alexist2623/QSTL_Amplifier/README.md

# QSTL_Amplifier
QSTL Baseband Amplifier

- [Current Altium Rev D review project](hardware/THS3491_RGT_G20/altium_revD/QSTL_THS3491_RGT_G20_RevD.PrjPcb)
- [Rev D changes, verification and Altium compatibility status](hardware/THS3491_RGT_G20/altium_revD/README.md)
- [Design requirements](DESIGN_REQUIREMENTS.md)

Rev D implements the latest capacitor and PD/NC placement corrections. It is a
review snapshot. Altium 25.8.1 open/save/reopen is verified after repairing track
and pad layer encoding; native ERC, repour and DRC remain pending.
