alexist2623/QSTL_Amplifier/hardware/THS3491_RGT_G20/altium_revD/review/bottom_mask_cleanup_baseline/README.md

Historical baseline before bottom-pad projection cleanup and mounting-via exposure, 2026-10-30.
