alexist2623/QSTL_Amplifier/hardware/THS3491_RGT_G20/altium_revD/review/mount_mask_baseline/README.md

Historical baseline before mounting-hole solder-mask expansion on 2026-10-30.
