alexist2623/QSTL_Amplifier/hardware/THS3491_RGT_G20/altium_revD/review/l3_cleanup_baseline/README.md

Historical baseline before the 2026-10-30 L3 plane cleanup. Current CAD files are in the parent altium_revD directory.
