alexist2623/QSTL_Amplifier/hardware/THS3491_RGT_G20/altium_revD/review/rf_resistor_windows_baseline/README.md

Historical verified baseline before the RF resistor-window/U1 correction on 2026-10-30.
