alexist2623/QSTL_Amplifier/hardware/THS3491_RGT_G20/altium_revD/review/bottom_ground_mask_and_vias.png

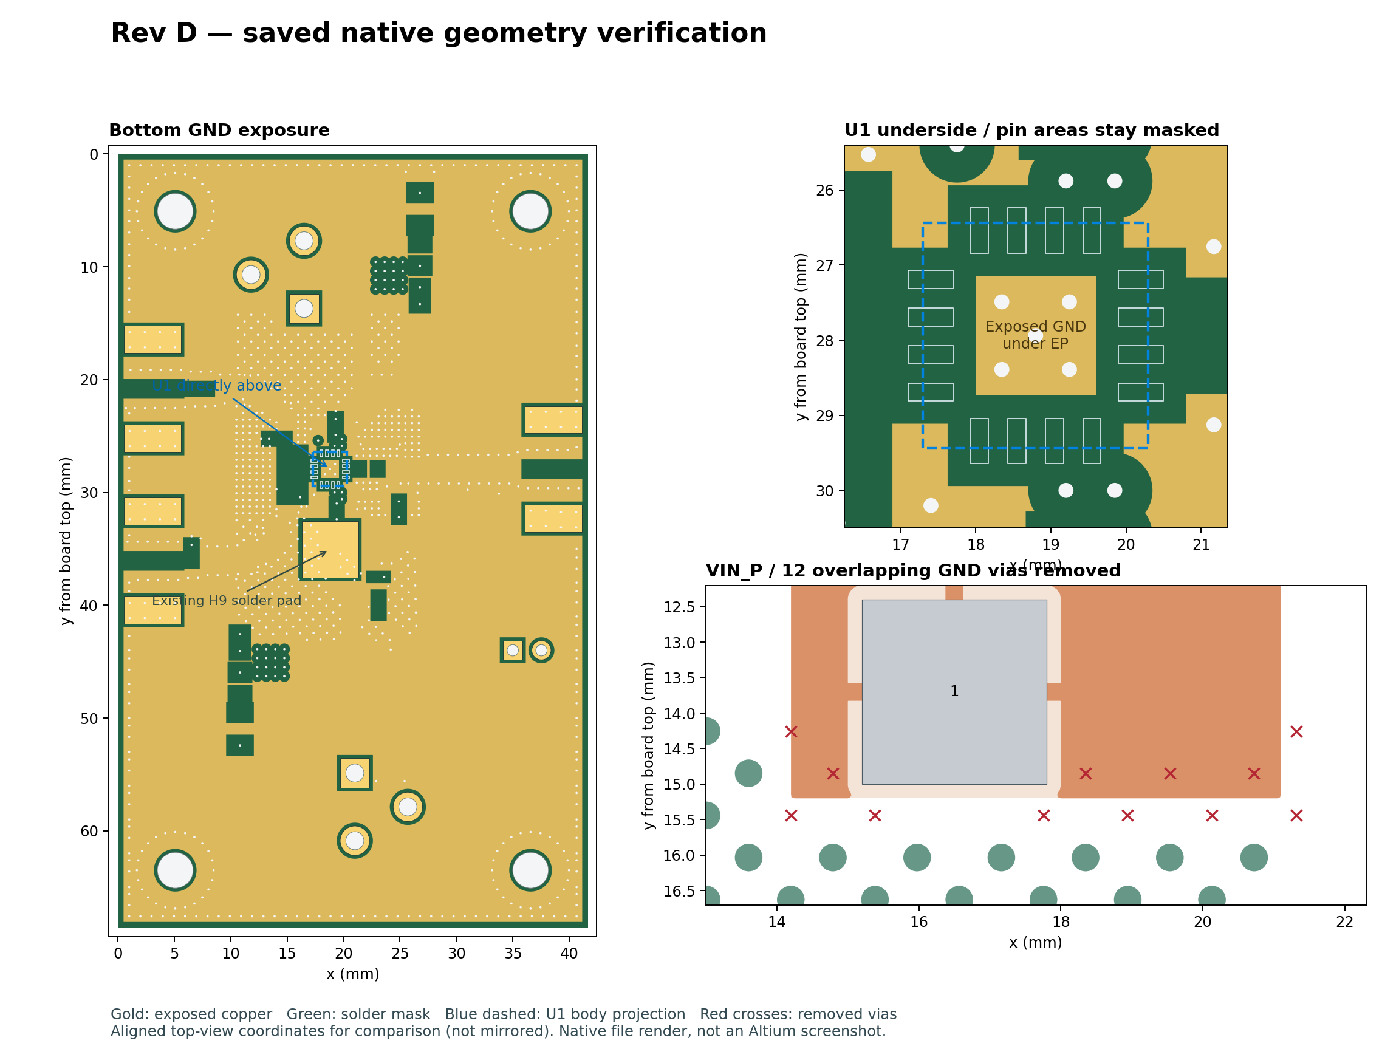
hardware/THS3491_RGT_G20/altium_revD/review/bottom_ground_mask_and_vias.png
