alexist2623/QSTL_Amplifier/hardware/THS3491_RGT_G20/altium_revD/review/bottom_mask_cleanup_before_after.png

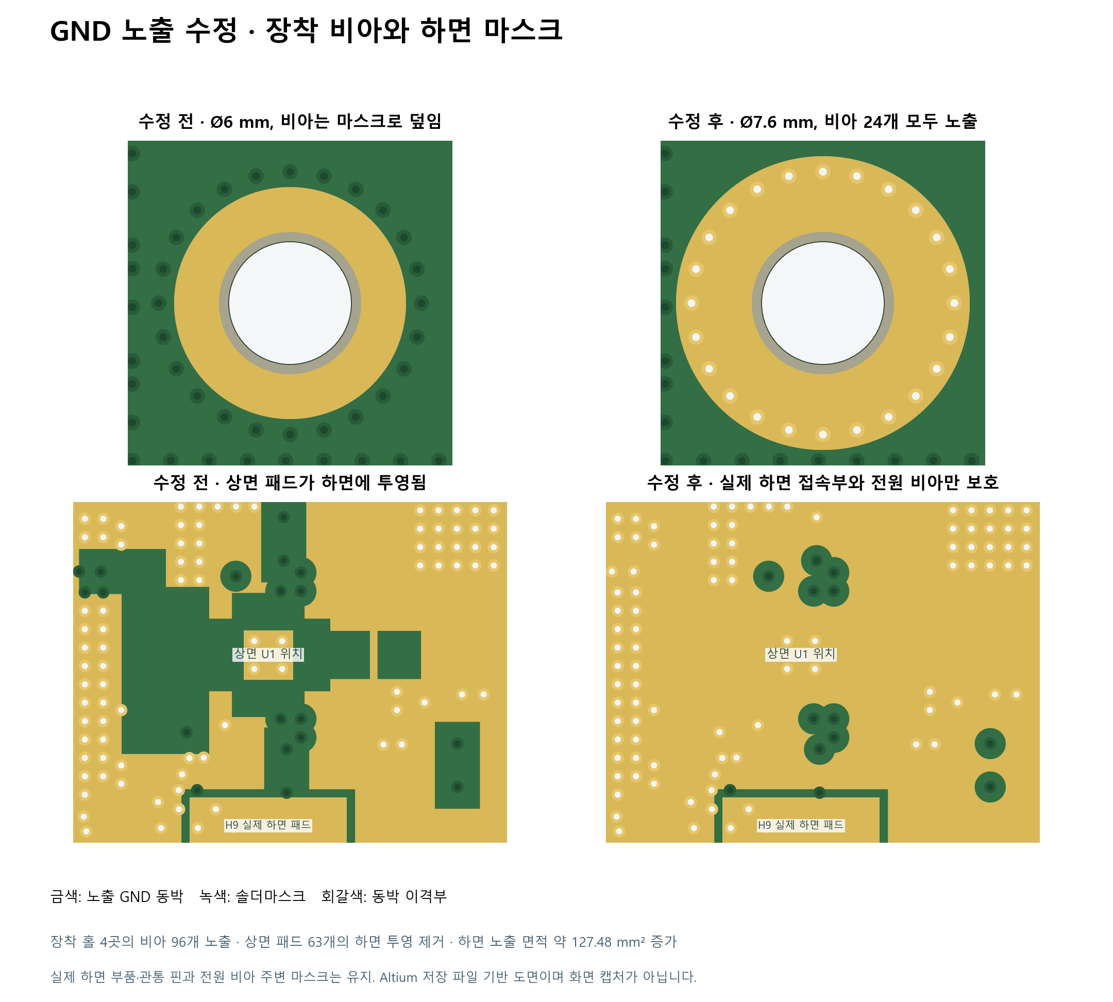
hardware/THS3491_RGT_G20/altium_revD/review/bottom_mask_cleanup_before_after.png
