alexist2623/QSTL_Amplifier/hardware/THS3491_RGT_G20/altium_revD/review/dc_plane_pinout.png

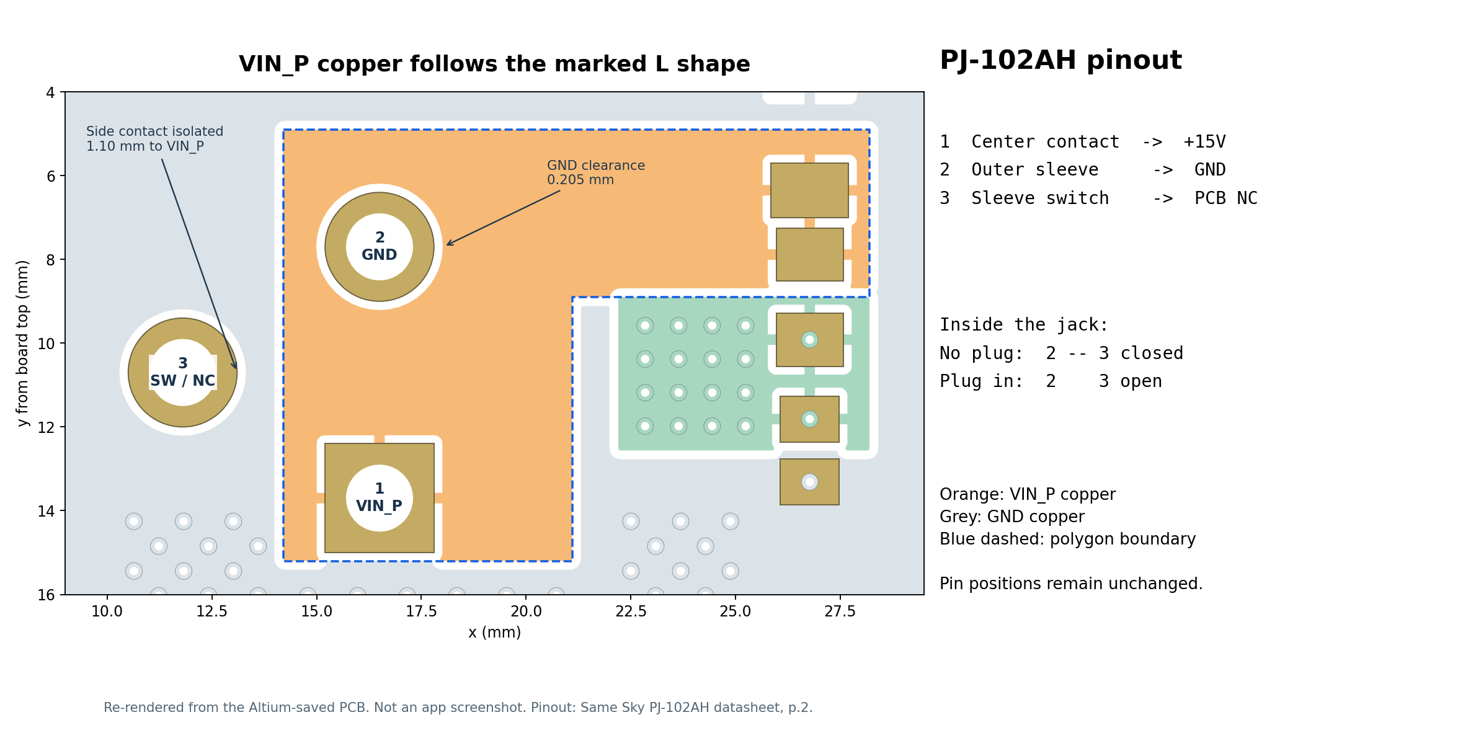
hardware/THS3491_RGT_G20/altium_revD/review/dc_plane_pinout.png
