alexist2623/QSTL_Amplifier/hardware/THS3491_RGT_G20/altium_revD/review/dc_planes_both.png

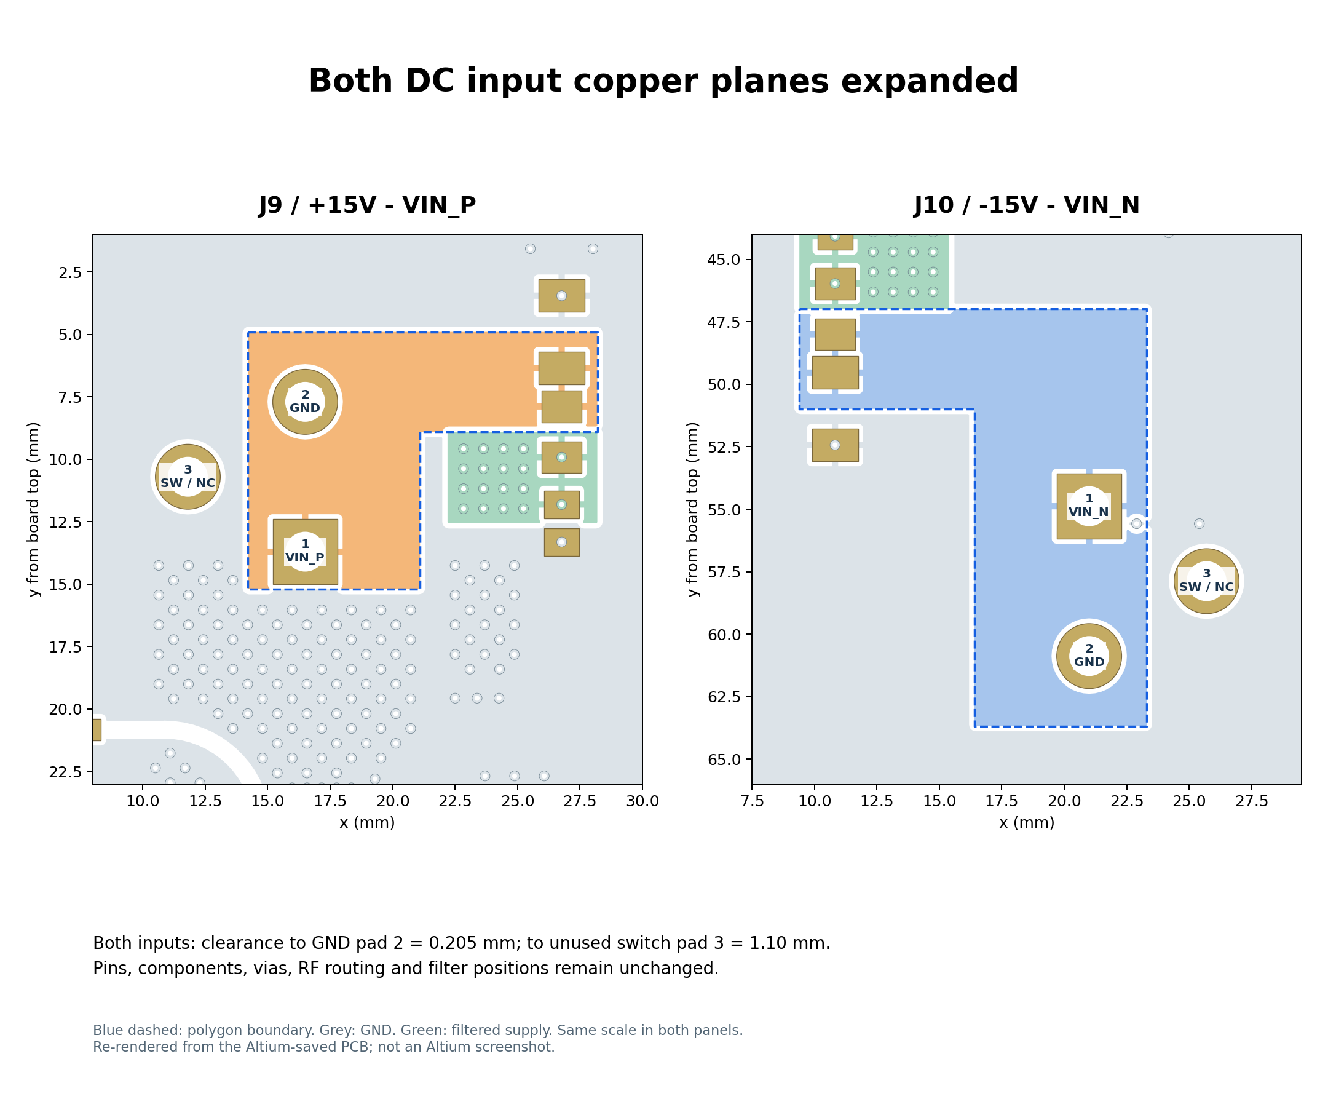
hardware/THS3491_RGT_G20/altium_revD/review/dc_planes_both.png
