alexist2623/QSTL_Amplifier/hardware/THS3491_RGT_G20/altium_revD/review/entry_plane_via_arrays.png

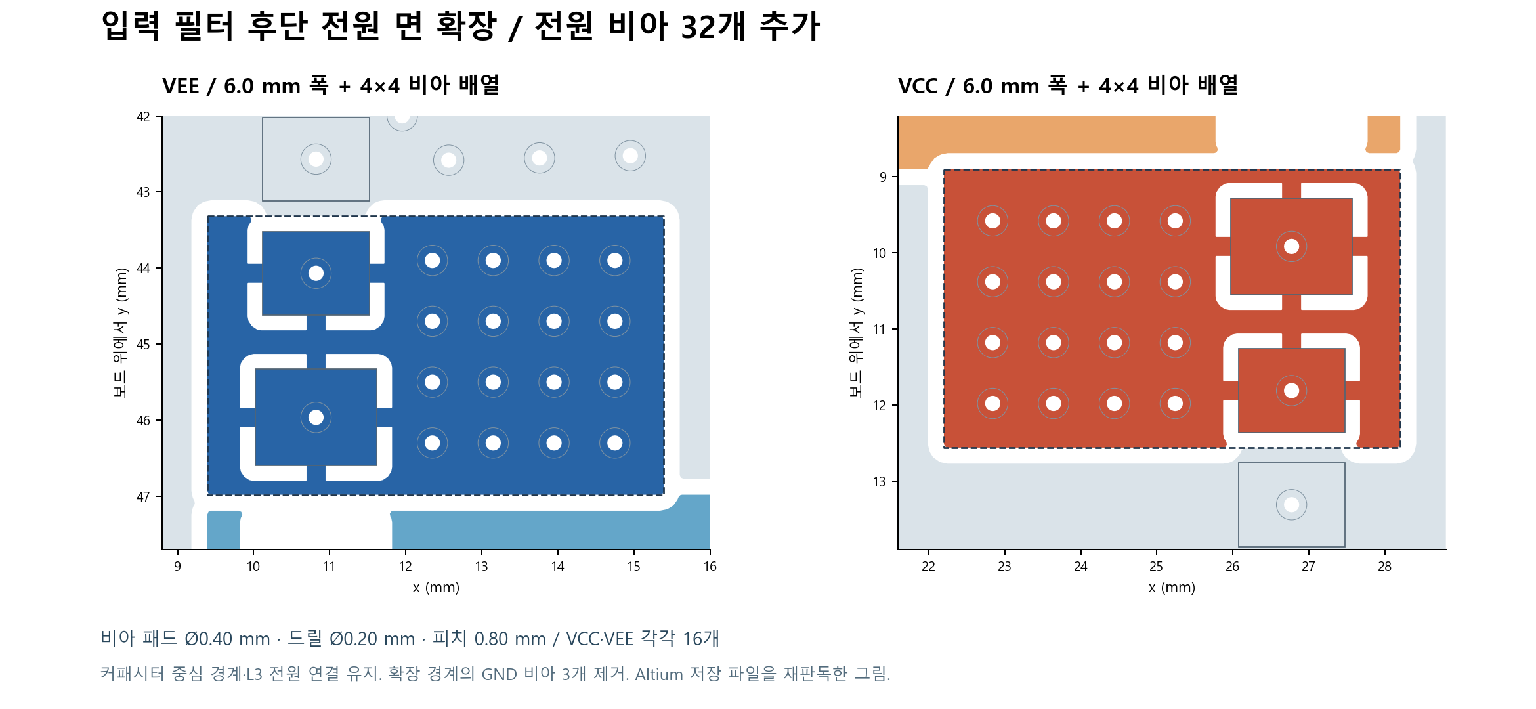
hardware/THS3491_RGT_G20/altium_revD/review/entry_plane_via_arrays.png
