alexist2623/QSTL_Amplifier/hardware/THS3491_RGT_G20/altium_revD/review/L2_resistor_windows_before_after.png

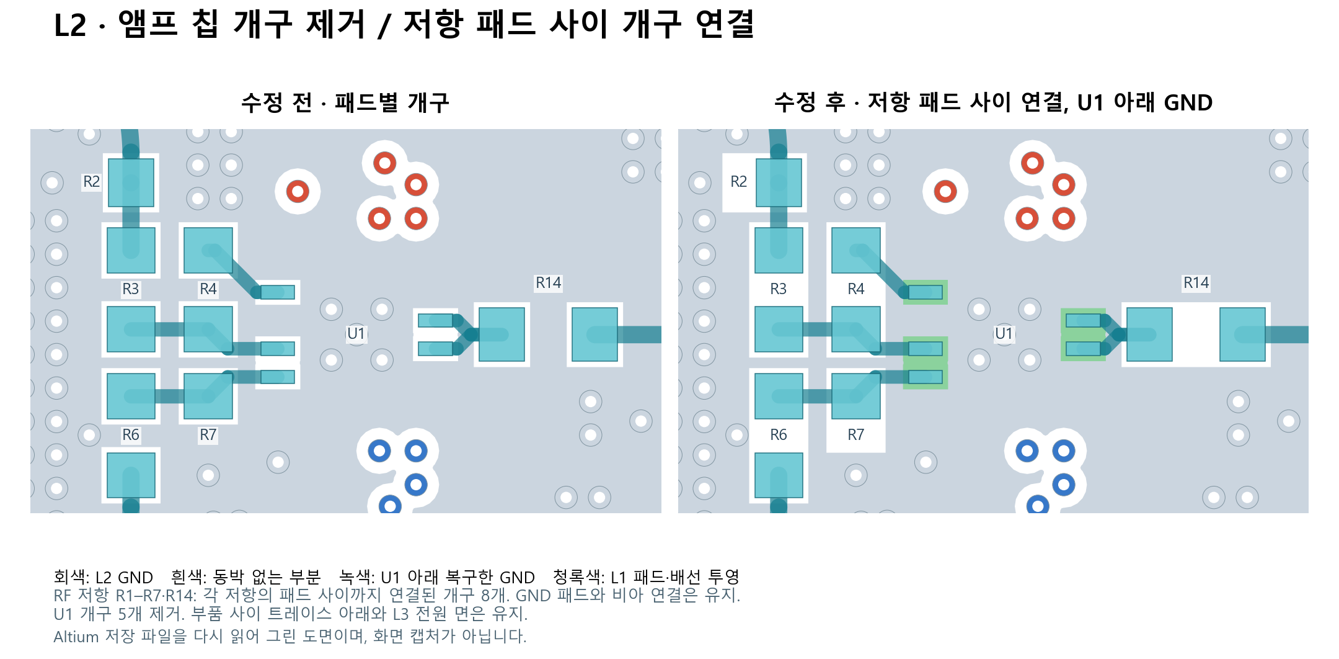
hardware/THS3491_RGT_G20/altium_revD/review/L2_resistor_windows_before_after.png
