alexist2623/QSTL_Amplifier/hardware/THS3491_RGT_G20/altium_revD/review/layers/L1-L4_overview.png

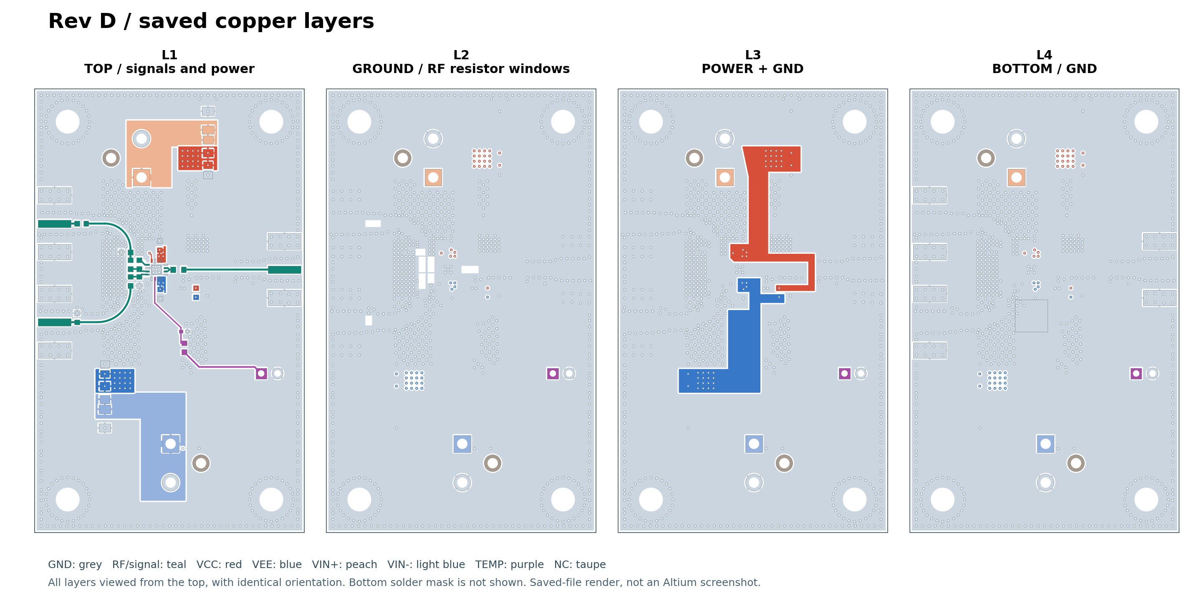
hardware/THS3491_RGT_G20/altium_revD/review/layers/L1-L4_overview.png
