alexist2623/QSTL_Amplifier/hardware/THS3491_RGT_G20/altium_revD/review/layers/L4.png

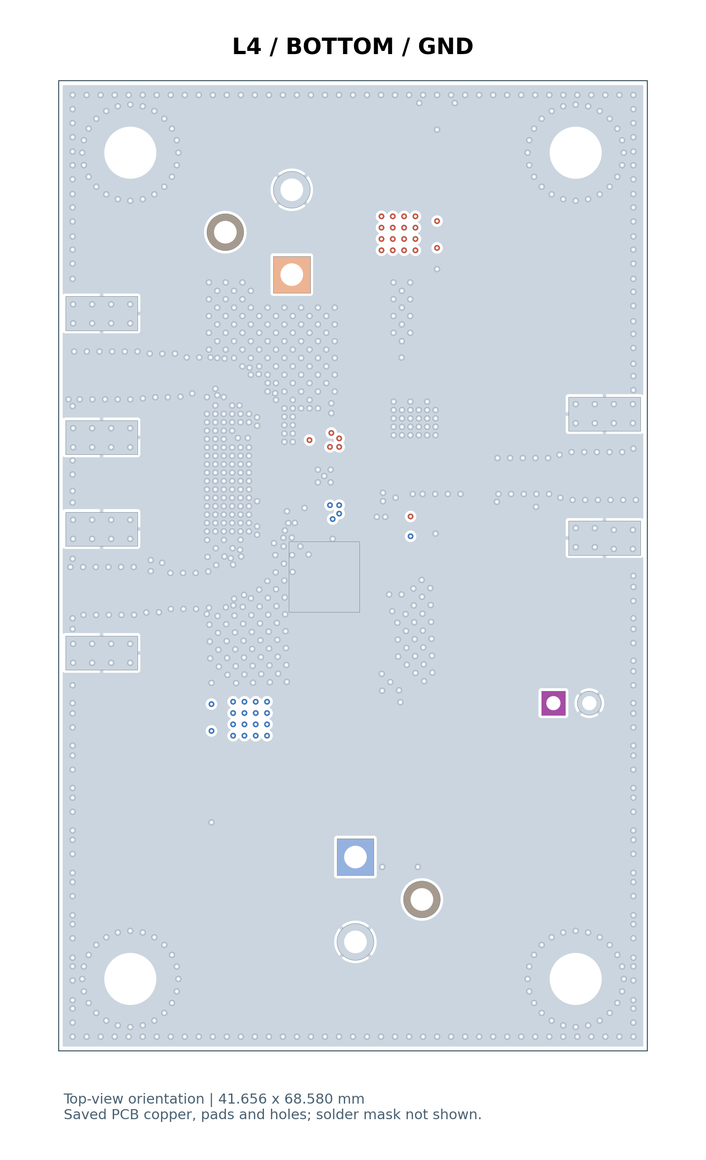
hardware/THS3491_RGT_G20/altium_revD/review/layers/L4.png
