alexist2623/QSTL_Amplifier/hardware/THS3491_RGT_G20/altium_revD/review/mechanical_compare_THS4021EVM.png

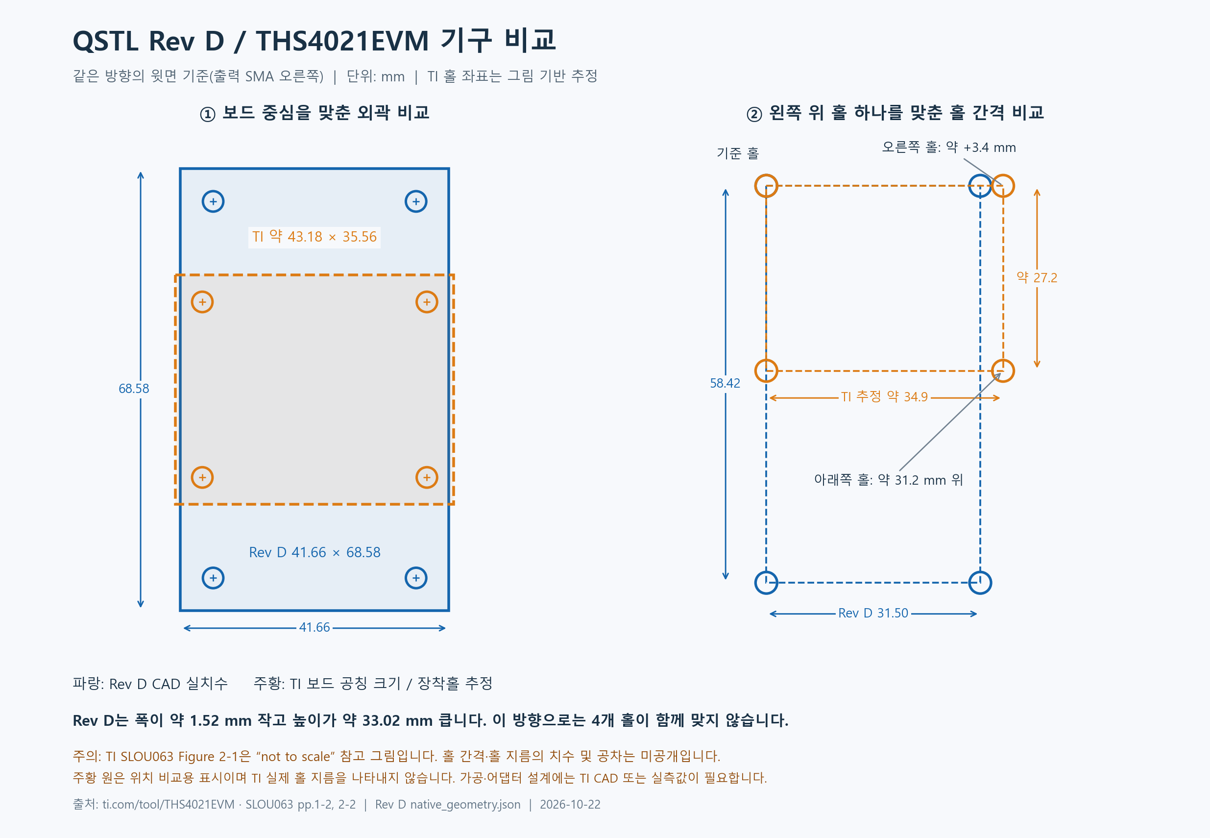
hardware/THS3491_RGT_G20/altium_revD/review/mechanical_compare_THS4021EVM.png
