alexist2623/QSTL_Amplifier/hardware/THS3491_RGT_G20/altium_revD/review/mechanical_hole_via_rings.png

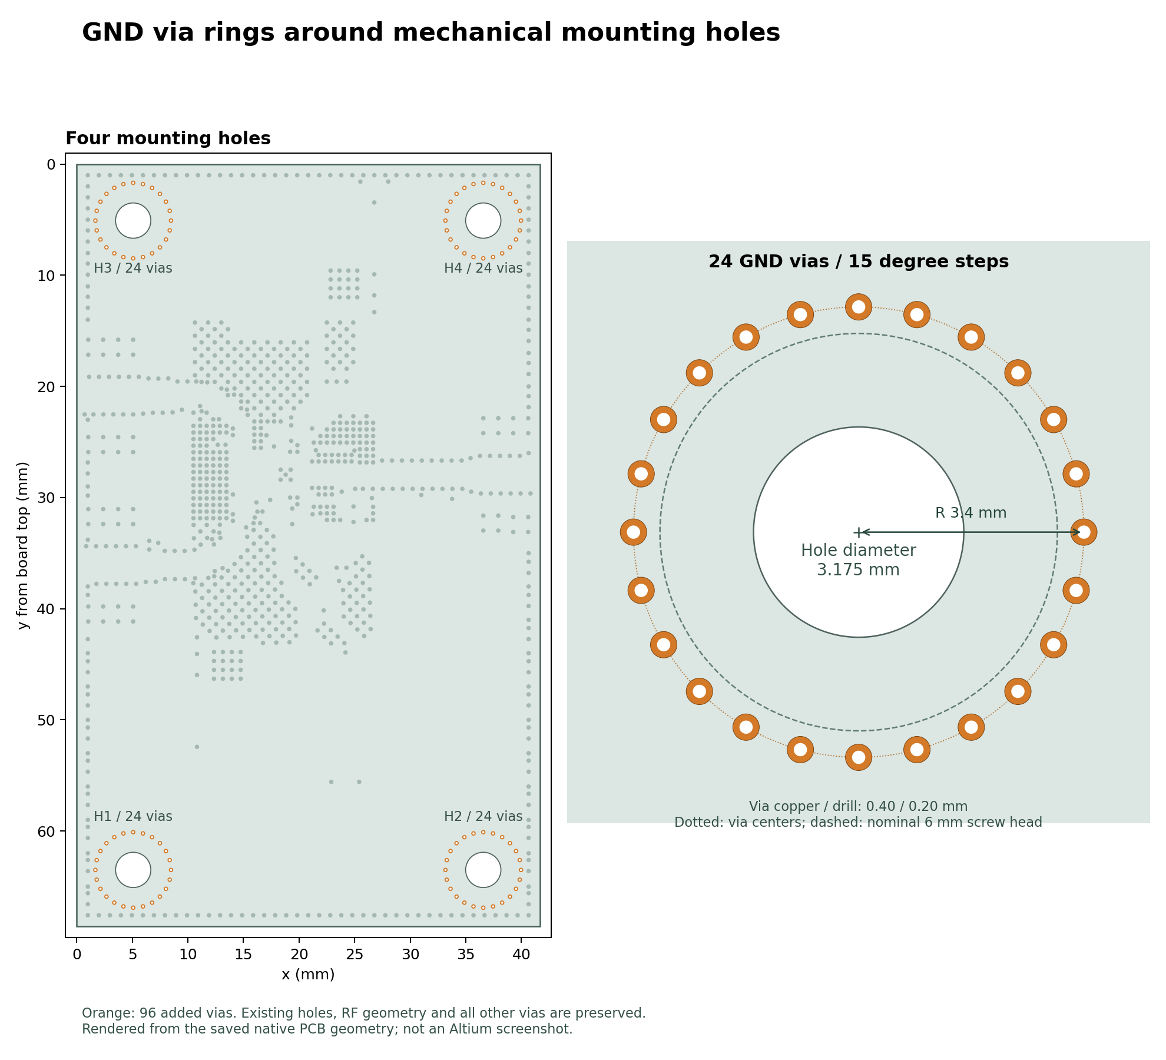
hardware/THS3491_RGT_G20/altium_revD/review/mechanical_hole_via_rings.png
