alexist2623/QSTL_Amplifier/hardware/THS3491_RGT_G20/altium_revD/review/mounting_hole_copper_exposure.png

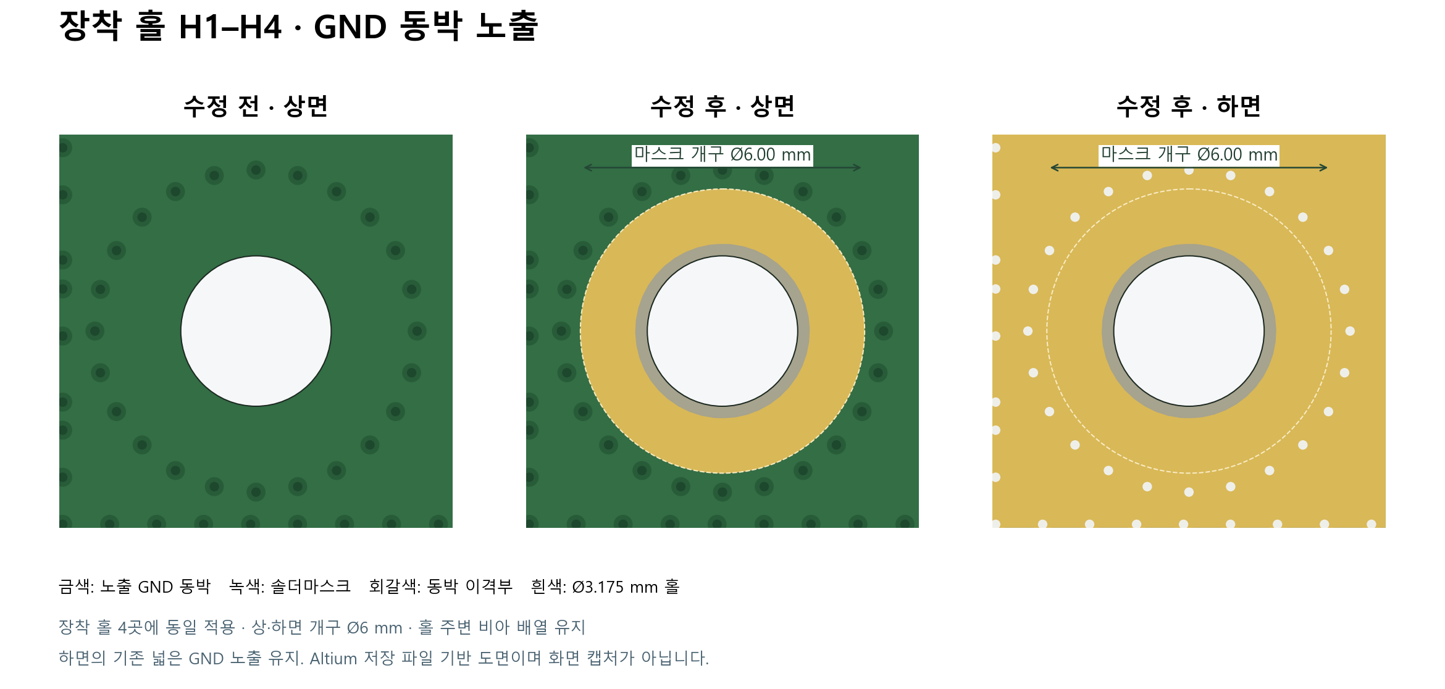
hardware/THS3491_RGT_G20/altium_revD/review/mounting_hole_copper_exposure.png
