alexist2623/QSTL_Amplifier/hardware/THS3491_RGT_G20/planning/power_plan_L1.png

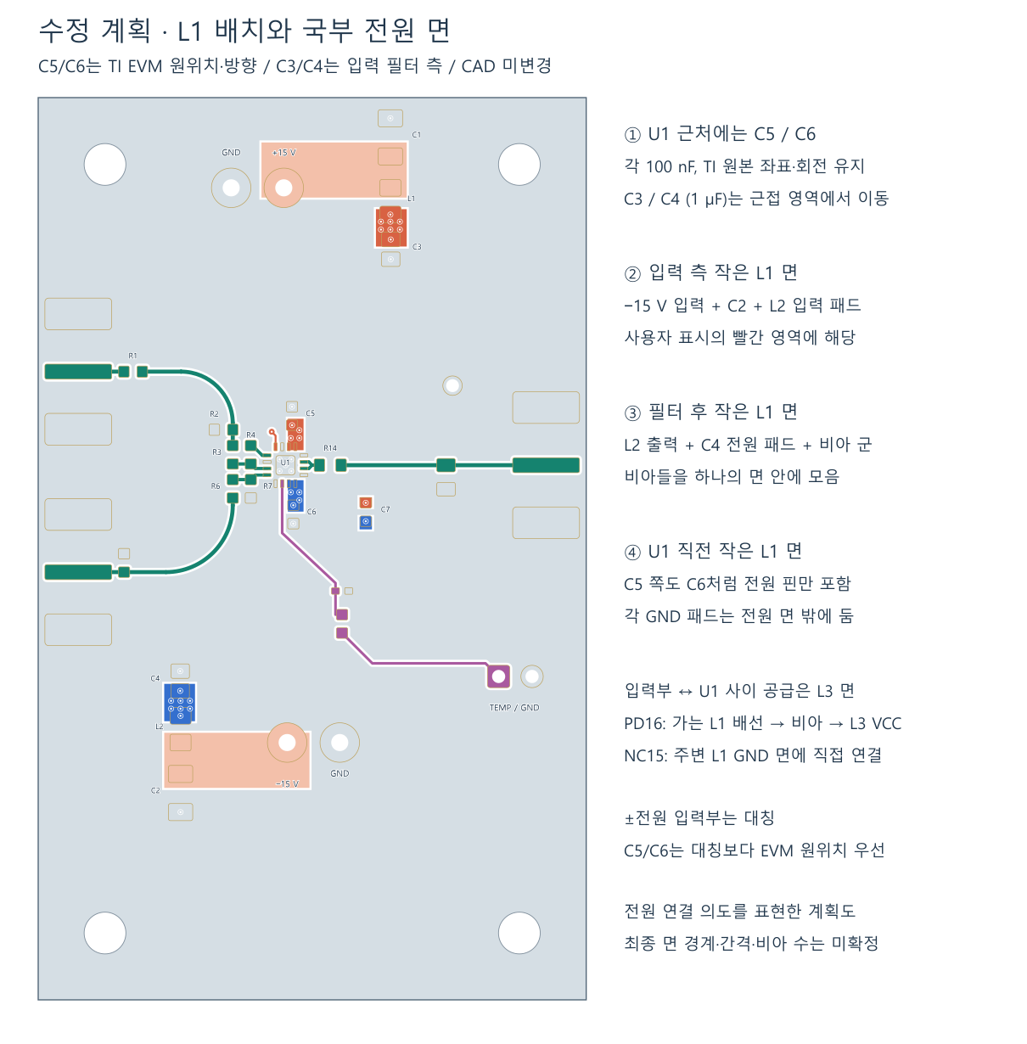
hardware/THS3491_RGT_G20/planning/power_plan_L1.png
