alexist2623/QSTL_Amplifier/hardware/THS3491_RGT_G20/planning/power_plan_PD_NC.png

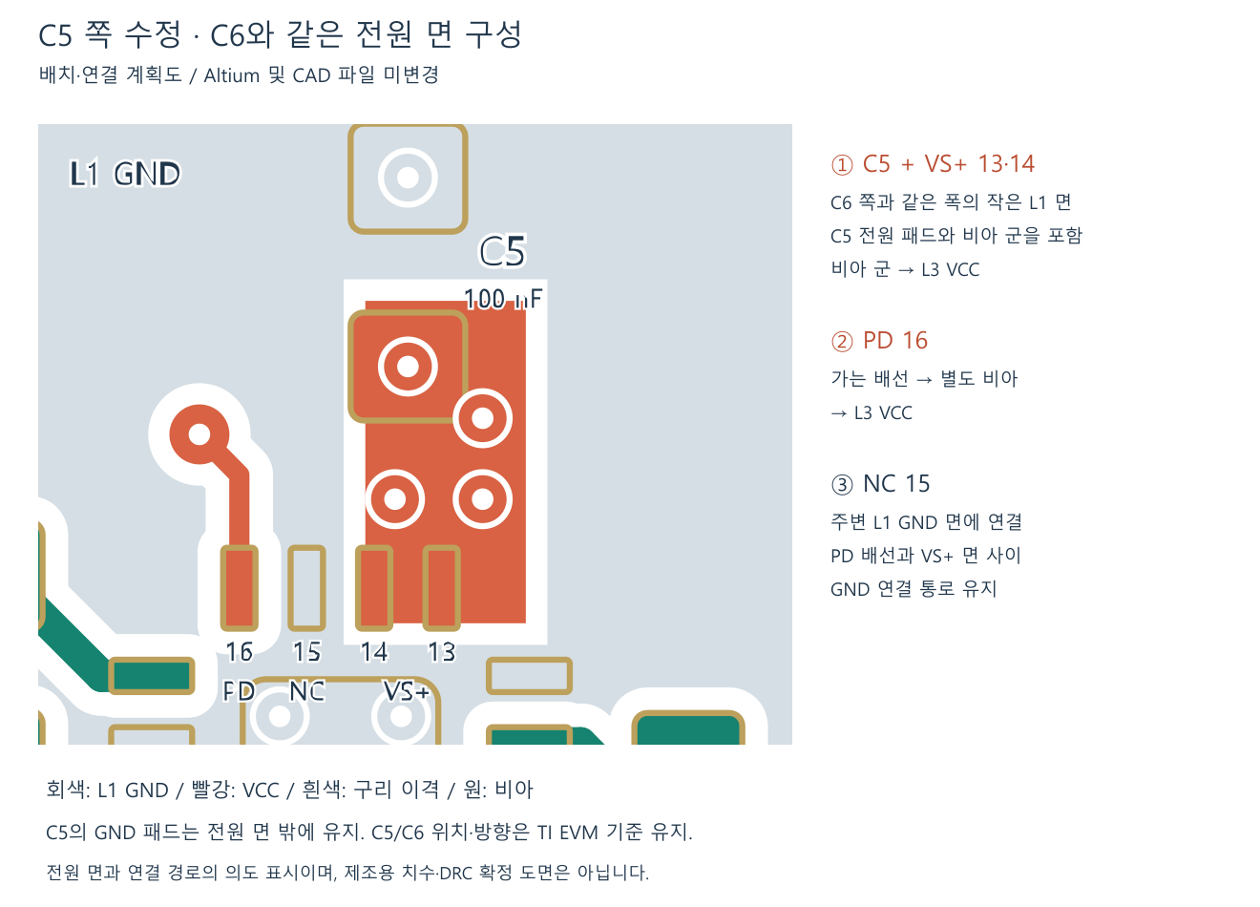
hardware/THS3491_RGT_G20/planning/power_plan_PD_NC.png
