alexist2623/QSTL_Amplifier/hardware/THS3491_RGT_G20/altium_revD/models3d/Ferrite_0805_H0p85.step

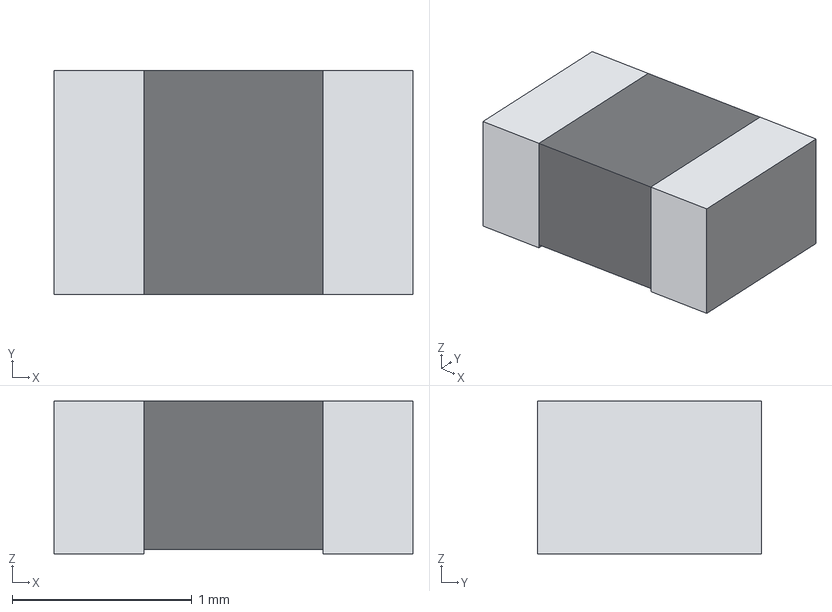
[picture p34: CAD file, 2026-10-29]
hardware/THS3491_RGT_G20/altium_revD/models3d/Ferrite_0805_H0p85.step
2.00 x 1.25 x 0.85 mm
