alexist2623/QSTL_Amplifier/hardware/THS3491_RGT_G20/altium_revD/models3d/sources/SMA_142-0701-851.stp

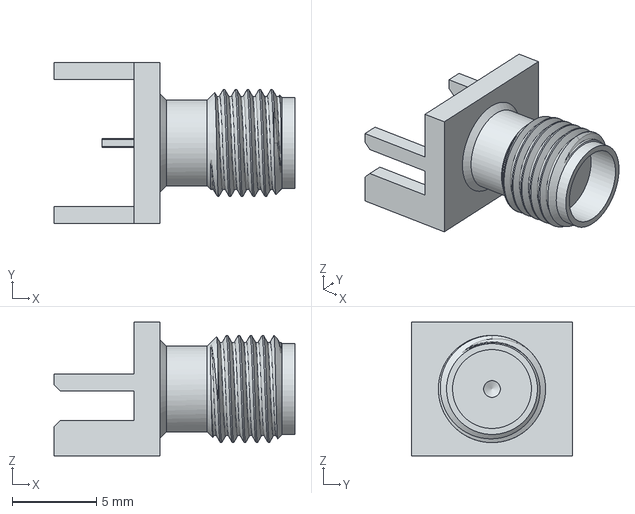
[picture p35: CAD file, 2026-10-29]
hardware/THS3491_RGT_G20/altium_revD/models3d/sources/SMA_142-0701-851.stp
14.3 x 9.53 x 7.92 mm
