alexist2623/QSTL_Amplifier/hardware/THS3491_RGT_G20/altium_revD/models3d/C_1206_H0p85.step

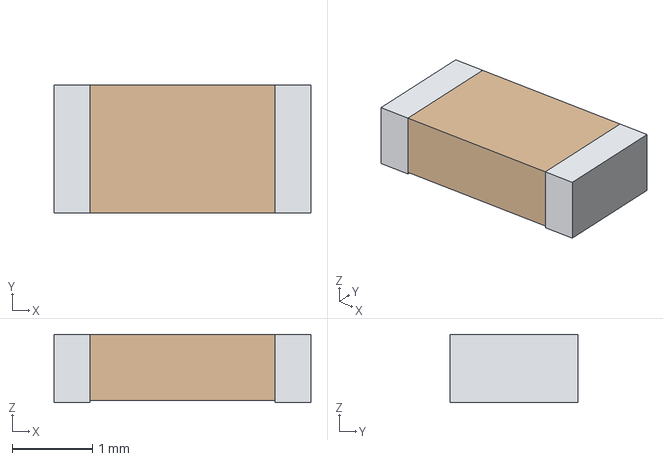
[picture p36: CAD file, 2026-10-29]
hardware/THS3491_RGT_G20/altium_revD/models3d/C_1206_H0p85.step
3.20 x 1.60 x 0.85 mm
