alexist2623/QSTL_Amplifier/hardware/THS3491_RGT_G20/altium_revD/models3d/C_0805.step

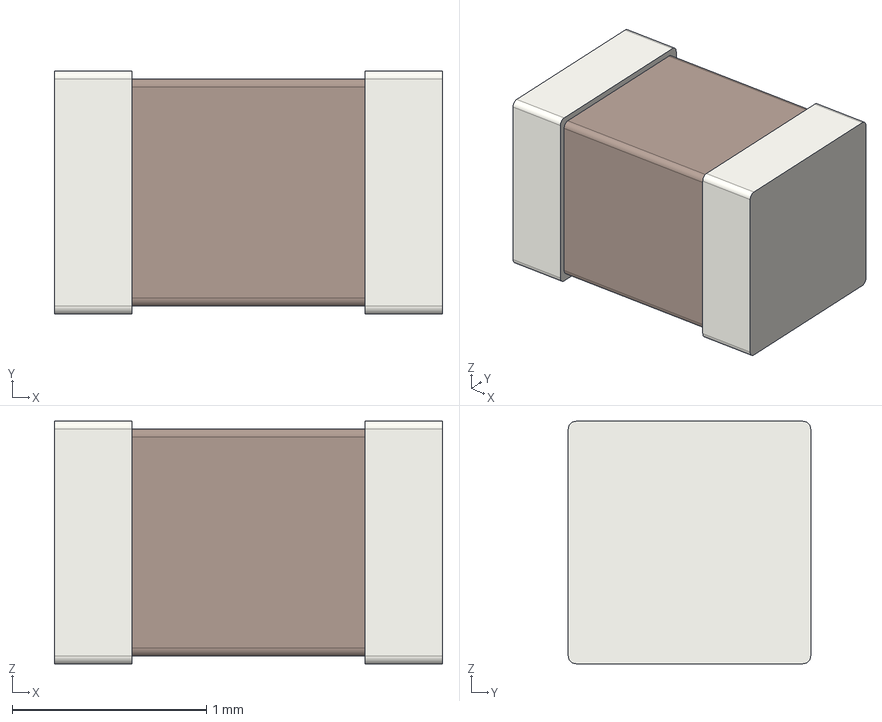
[picture p37: CAD file, 2026-10-29]
hardware/THS3491_RGT_G20/altium_revD/models3d/C_0805.step
2.00 x 1.25 x 1.25 mm
