alexist2623/QSTL_Amplifier/hardware/THS3491_RGT_G20/altium_revD/models3d/THS3491_RGT_nominal.step

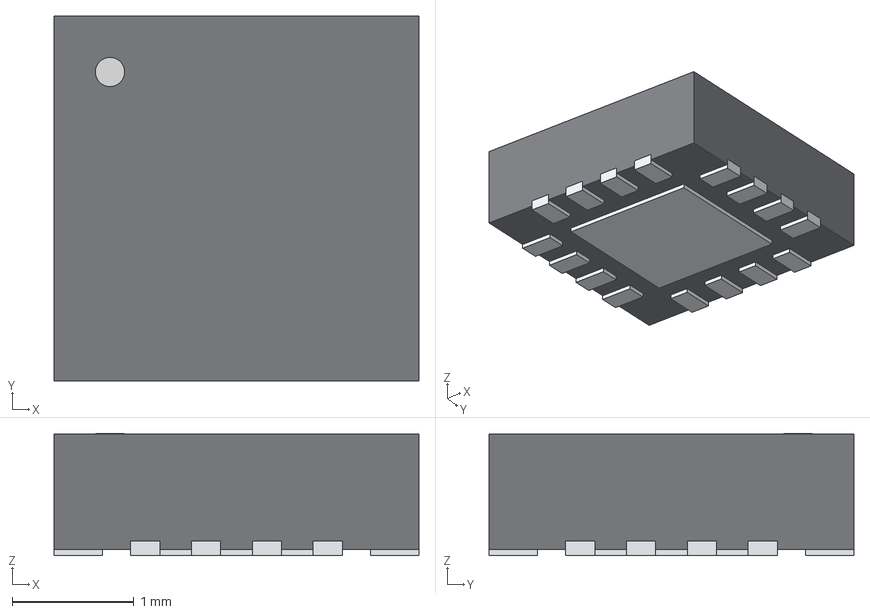
[picture p38: CAD file, 2026-10-29]
hardware/THS3491_RGT_G20/altium_revD/models3d/THS3491_RGT_nominal.step
3.00 x 3.00 x 1.01 mm
