alexist2623/QSTL_Amplifier/hardware/THS3491_RGT_G20/altium_revD/models3d/R_0603.step

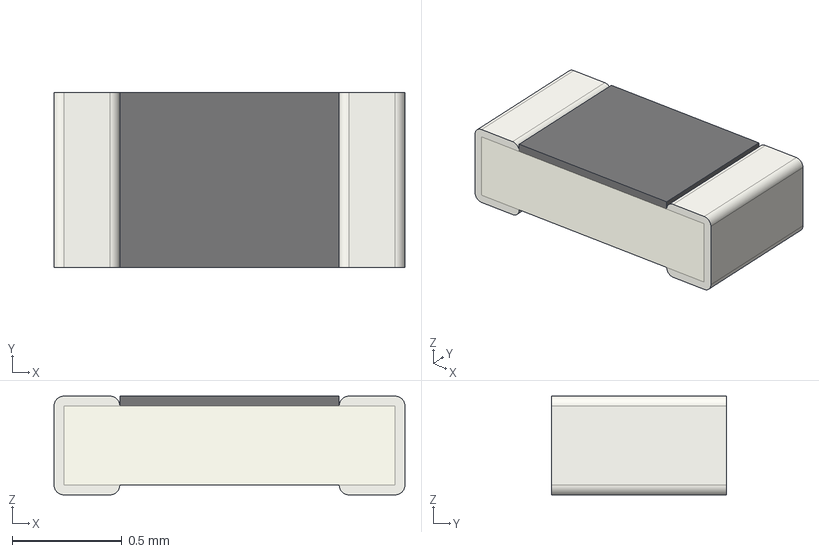
[picture p39: CAD file, 2026-10-29]
hardware/THS3491_RGT_G20/altium_revD/models3d/R_0603.step
1.60 x 0.8 x 0.45 mm
