alexist2623/QSTL_Amplifier/hardware/THS3491_RGT_G20/altium_revD/models3d/C_0603.step

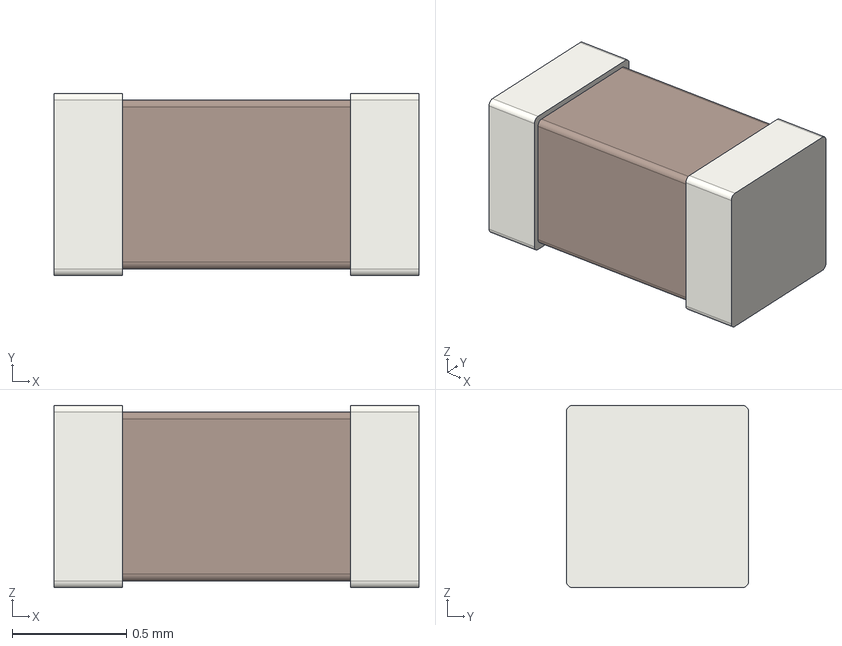
[picture p40: CAD file, 2026-10-29]
hardware/THS3491_RGT_G20/altium_revD/models3d/C_0603.step
1.60 x 0.8 x 0.8 mm
