alexist2623/QSTL_Amplifier/hardware/THS3491_RGT_G20/altium_revD/models3d/PJ-102AH_nominal.step

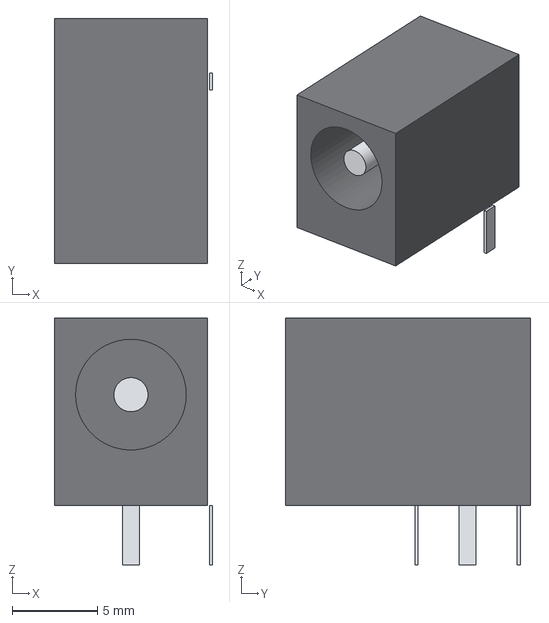
[picture p41: CAD file, 2026-10-29]
hardware/THS3491_RGT_G20/altium_revD/models3d/PJ-102AH_nominal.step
9.30 x 14.4 x 14.5 mm
