alexist2623/QSTL_Amplifier/hardware/THS3491_RGT_G20/altium_revD/models3d/ElectroPJP_20054_nominal.step

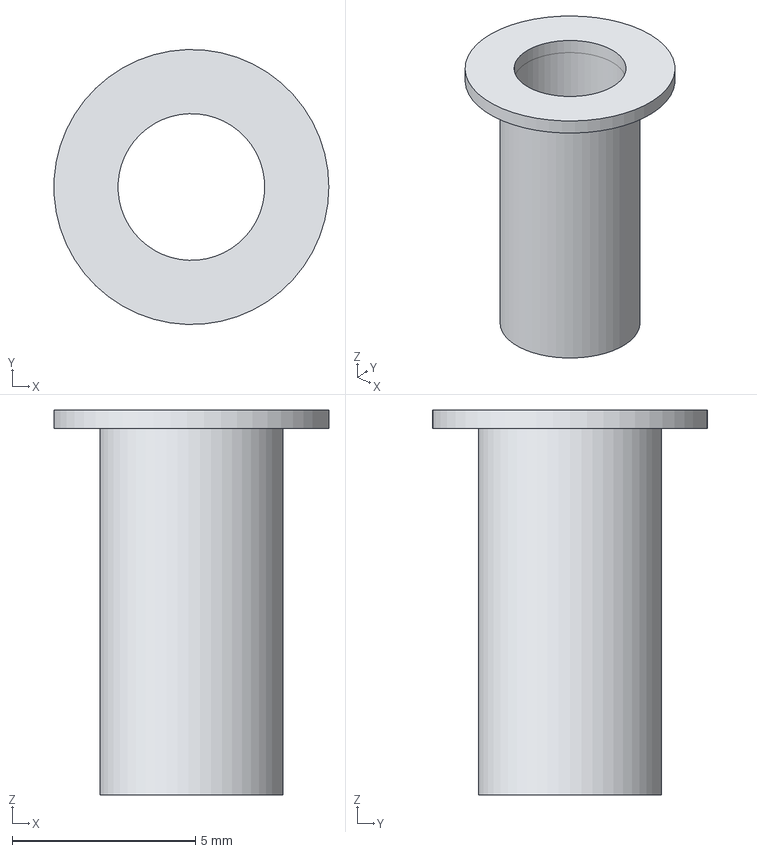
[picture p42: CAD file, 2026-10-29]
hardware/THS3491_RGT_G20/altium_revD/models3d/ElectroPJP_20054_nominal.step
7.49 x 7.50 x 10.5 mm
