alexist2623/QSTL_Amplifier/hardware/THS3491_RGT_G20/altium_revD/models3d/Keystone_575_6_nominal.step

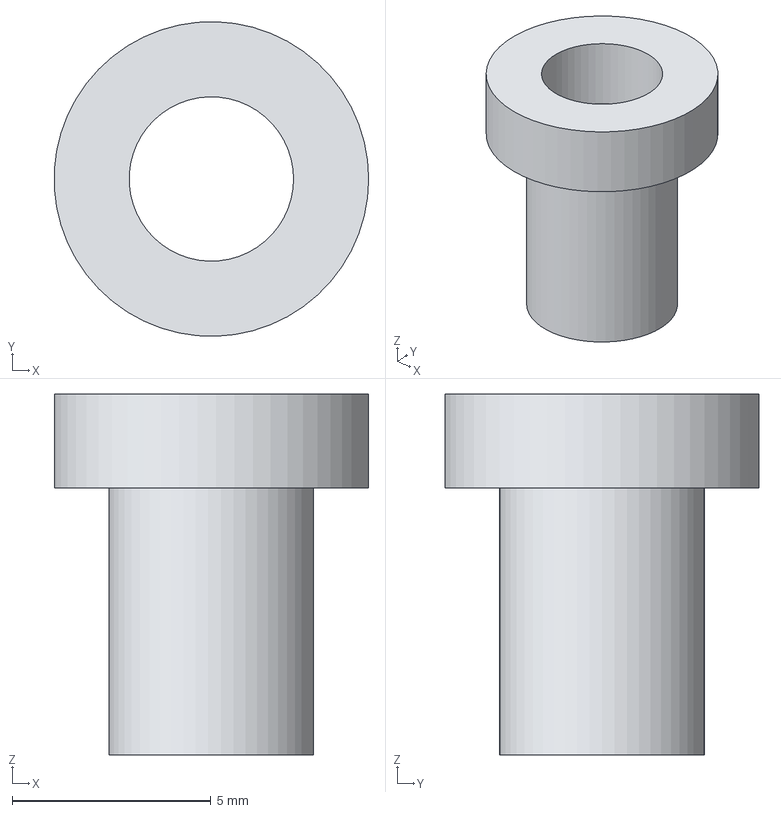
[picture p43: CAD file, 2026-10-29]
hardware/THS3491_RGT_G20/altium_revD/models3d/Keystone_575_6_nominal.step
7.92 x 7.92 x 9.09 mm
