alexist2623/QSTL_Amplifier/hardware/THS3491_RGT_G20/altium_revD/models3d/C_0402.step

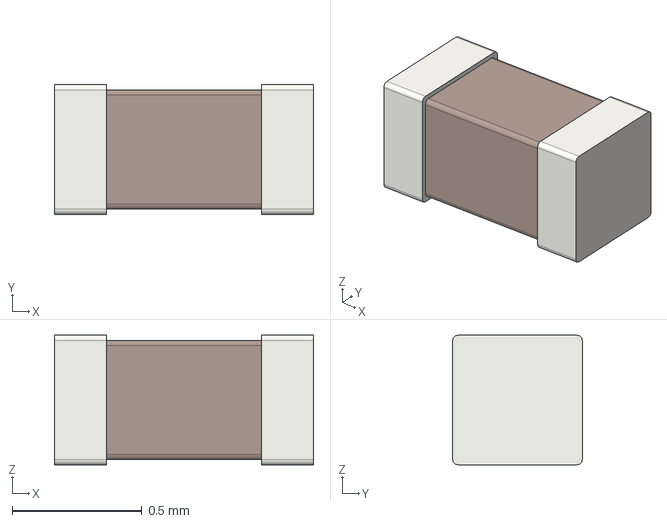
[picture p44: CAD file, 2026-10-29]
hardware/THS3491_RGT_G20/altium_revD/models3d/C_0402.step
1.00 x 0.5 x 0.5 mm
