alexist2623/QSTL_Amplifier/hardware/THS3491_RGT_G20/altium_revD/models3d/7109DG_simplified.step

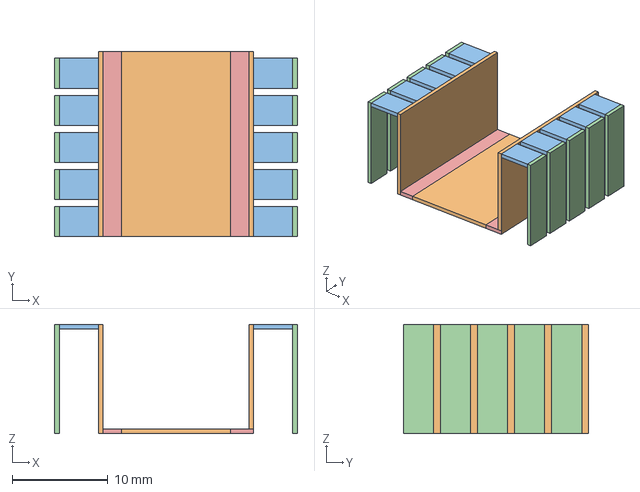
[picture p45: CAD file, 2026-10-29]
hardware/THS3491_RGT_G20/altium_revD/models3d/7109DG_simplified.step
25.4 x 19.4 x 11.4 mm
