alexist2623/QSTL_Amplifier/hardware/THS3491_RGT_G20/altium_revD/models3d/Header_1x02_2p54.step

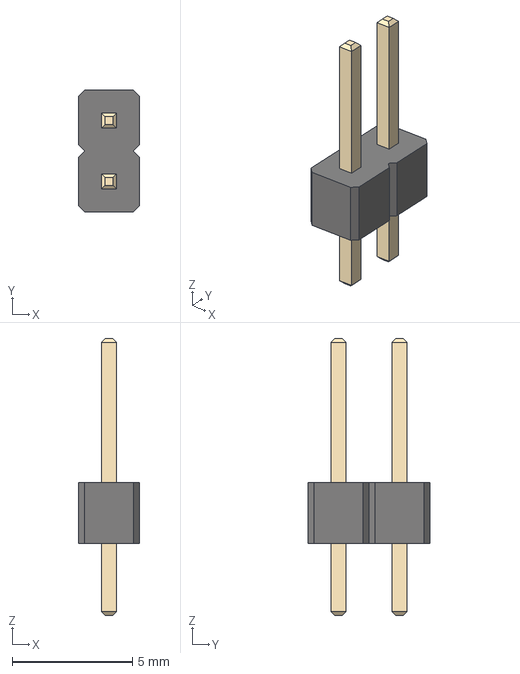
[picture p46: CAD file, 2026-10-29]
hardware/THS3491_RGT_G20/altium_revD/models3d/Header_1x02_2p54.step
2.54 x 5.08 x 11.5 mm
