alexist2623/QSTL_Amplifier/(list of files, cad)

Other CAD files:
hardware/THS3491_RGT_G20/altium_revD/models3d/SMA_142-0701-851_seated.step
