alexist2623/QSTL_Amplifier/hardware/THS3491_RGT_G20/altium_revD/review/input_rectangle_verification.png

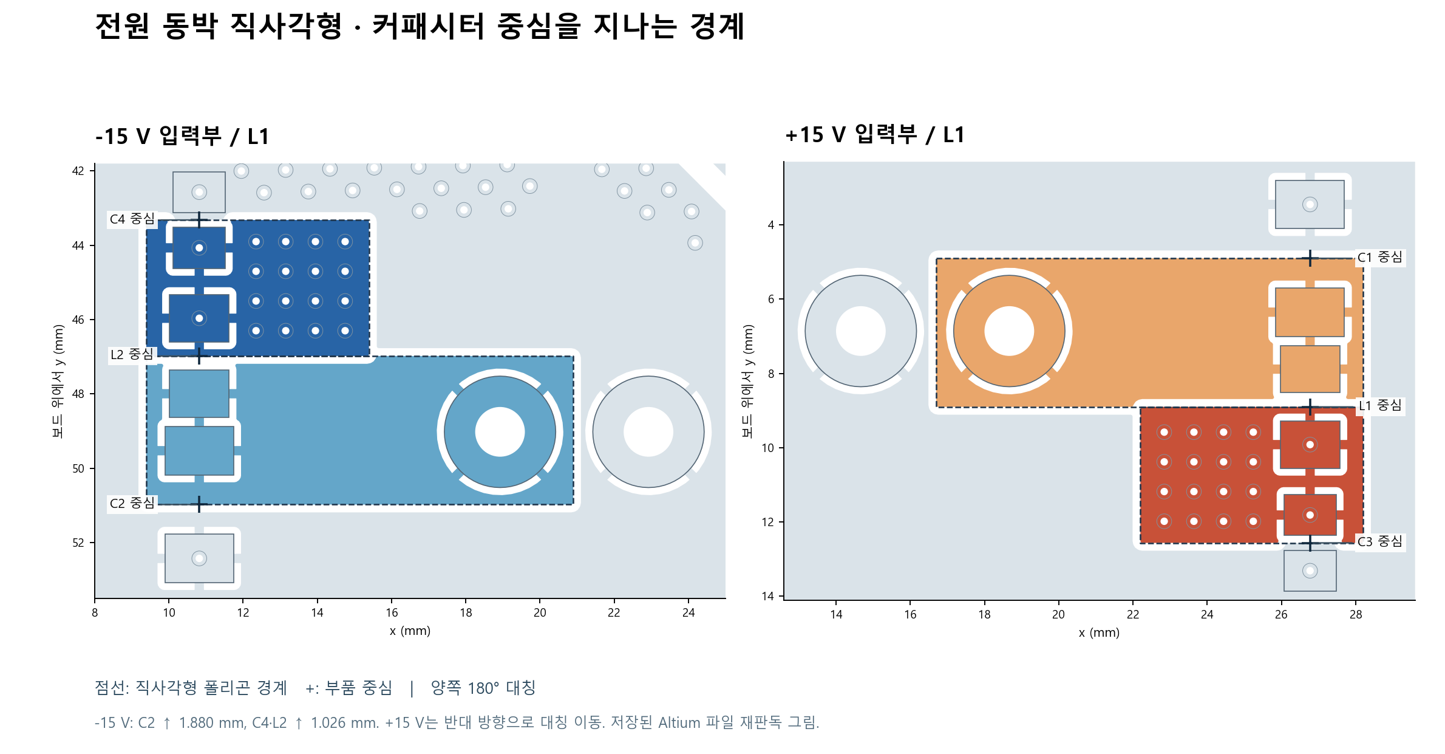
hardware/THS3491_RGT_G20/altium_revD/review/input_rectangle_verification.png
