alexist2623/QSTL_Amplifier/hardware/THS3491_RGT_G20/altium_revD/review/pad_shape_verification.png

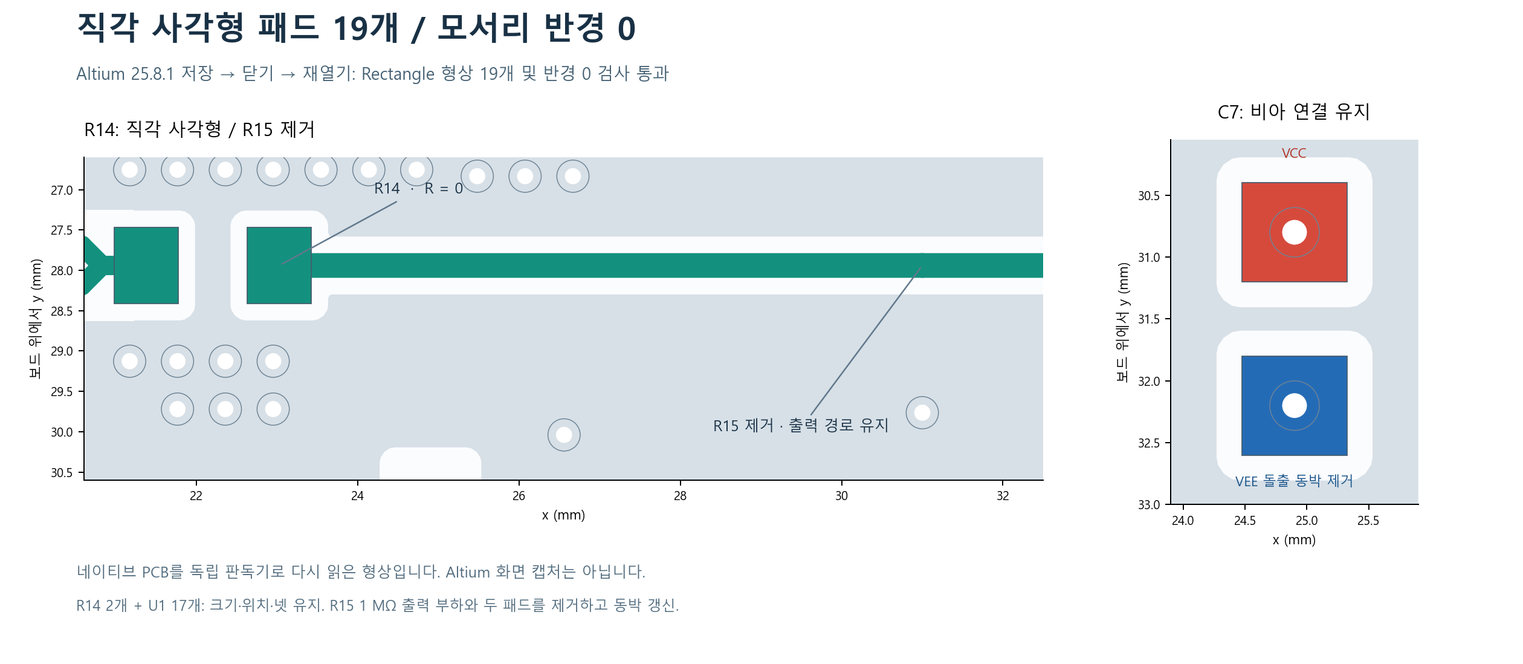
hardware/THS3491_RGT_G20/altium_revD/review/pad_shape_verification.png
