alexist2623/QSTL_Amplifier/hardware/THS3491_RGT_G20/altium_revC/review/TI_original_schematic_highlighted.pdf

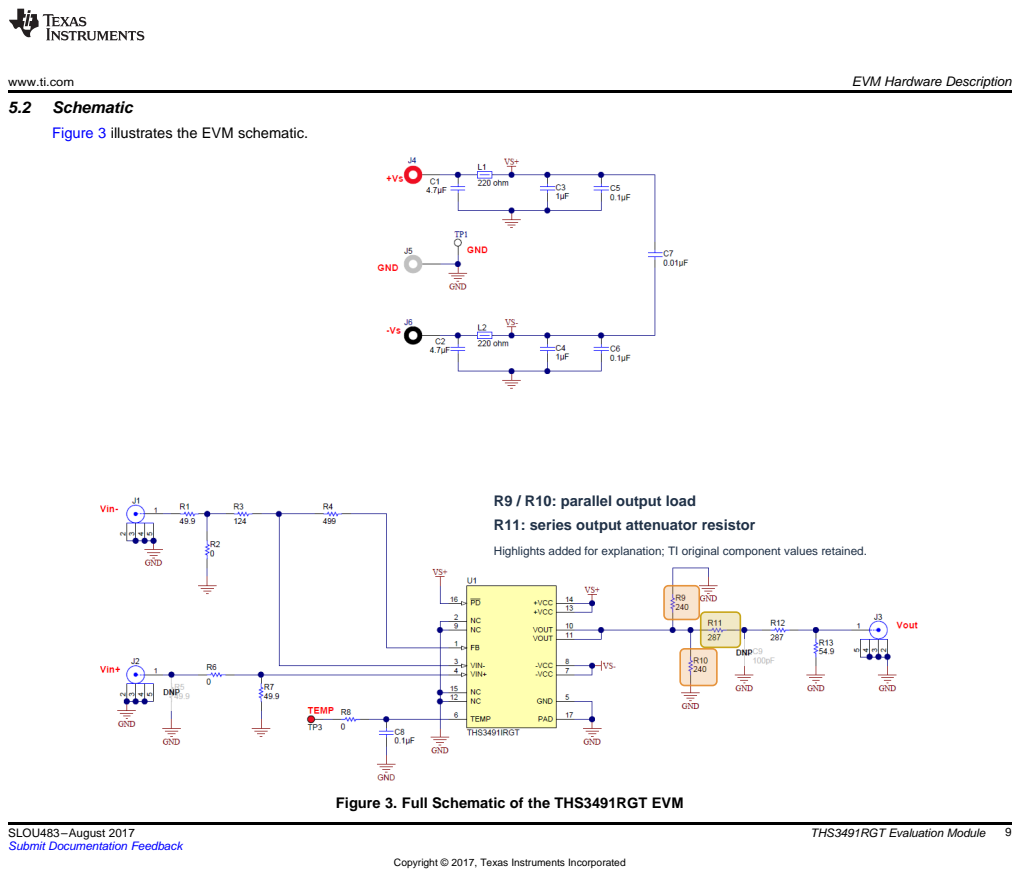
[picture p49: page 1]
www.ti.com; EVM Hardware Description; SLOU483–August 2017; THS3491RGT Evaluation Module; 5.2 Schematic

Figure 3 illustrates the EVM schematic.

R9 / R10: parallel output load
R11: series output attenuator resistor

Highlights added for explanation; TI original component values retained.

Figure 3. Full Schematic of the THS3491RGT EVM

Submit Documentation Feedback (http://www.go-dsp.com/forms/techdoc/doc_feedback.htm?litnum=SLOU483)

Copyright © 2017, Texas Instruments Incorporated
