alexist2623/QSTL_Amplifier/(list of files, drawings)

Other design files:
hardware/THS3491_RGT_G20/altium_revC/QSTL_THS3491_RGT_G20_RevC.PcbDoc
hardware/THS3491_RGT_G20/altium_revC/QSTL_THS3491_RGT_G20_RevC.PrjPcb
hardware/THS3491_RGT_G20/altium_revC/review/schematic_connectivity.json
hardware/THS3491_RGT_G20/altium_revC/review/schematic_native_records.json
hardware/THS3491_RGT_G20/altium_revD/QSTL_THS3491_RGT_G20_RevD.PcbDoc
hardware/THS3491_RGT_G20/altium_revD/QSTL_THS3491_RGT_G20_RevD.PrjPcb
hardware/THS3491_RGT_G20/altium_revD/review/bottom_mask_cleanup_baseline/before.PcbDoc
hardware/THS3491_RGT_G20/altium_revD/review/bottom_mask_cleanup_baseline/before.SchDoc
hardware/THS3491_RGT_G20/altium_revD/review/l3_cleanup_baseline/before.PcbDoc
hardware/THS3491_RGT_G20/altium_revD/review/mount_mask_baseline/before.PcbDoc
hardware/THS3491_RGT_G20/altium_revD/review/mount_mask_baseline/before.SchDoc
hardware/THS3491_RGT_G20/altium_revD/review/rf_resistor_windows_baseline/before.PcbDoc
hardware/THS3491_RGT_G20/altium_revD/review/tp1_removal_baseline/before.PcbDoc
hardware/THS3491_RGT_G20/altium_revD/review/tp1_removal_baseline/before.SchDoc
