alexist2623/QSTL_Amplifier/(commit log)

2026-10-22 hardware: publish Altium Rev C and latest layout plans
    [BOM_MANUAL_REVIEW.csv, BOM_REVIEW.csv, BOM_SMT_REVIEW.csv, QSTL_THS3491_RGT_G20_RevC.PcbDoc, QSTL_THS3491_RGT_G20_RevC.PrjPcb, QSTL_THS3491_RGT_G20_RevC.SchDoc, VIA_IN_PAD_PROCESS_REVIEW.csv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]
2026-10-23 hardware: publish verified Altium Rev D layout and repair tooling
    [BOM_MANUAL_REVIEW.csv, BOM_REVIEW.csv, BOM_SMT_REVIEW.csv, QSTL_THS3491_RGT_G20_RevD.PcbDoc, QSTL_THS3491_RGT_G20_RevD.PrjPcb, QSTL_THS3491_RGT_G20_RevD.SchDoc, VIA_IN_PAD_PROCESS_REVIEW.csv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]
2026-10-29 hardware: finalize Rev D power inputs, 3D models and ground stitching
    [7109DG_simplified.step, BOM_MANUAL_REVIEW.csv, BOM_REVIEW.csv, BOM_SMT_REVIEW.csv, C_0402.step, C_0603.step, C_0805.step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]
2026-10-30 hardware: clean Rev D power planes and RF resistor windows
    [QSTL_THS3491_RGT_G20_RevD.PcbDoc, before.PcbDoc, before.SchDoc]
2026-10-30 hardware: expose mounting via rings and correct bottom solder mask
    [QSTL_THS3491_RGT_G20_RevD.PcbDoc, before.PcbDoc, before.SchDoc]
